dgreco-debug/cat-tracker/(commit log)

2026-10-14 Cat tracker: collar + base firmware v2 and web app
    Collar (XIAO nRF52840 + Wio-SX1262 + M10 GPS): periodic GPS reports over LoRa,
    settings saved in flash and changeable over LoRa, Bluetooth or USB.
    Base (Heltec V4): BLE/USB JSON bridge, command queue, history, chat between bases.
    App (Vite + Preact + Leaflet PWA): live map with trail and distance to the cat,
    collar settings, activity log, chat, demo mode. Deployed to GitHub Pages.
    Claude-Session: https://claude.ai/code/session_01GZnRQ6rdyr5X5z8jqkyW2t
    [partitions.csv]
2026-10-14 Add handoff doc, CLAUDE.md, and collar restart-into-update-mode
    - HANDOFF.md: state at handoff, what is verified vs untested, build/flash notes, open questions
    - CLAUDE.md: repo conventions for Claude Code
    - Collar: {"cmd":"dfu"} / 'dfu' restarts into the UF2 bootloader; app button in Collar tab
    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
2026-10-14 App: 100 mAh battery estimate and days-left countdown from recent check-ins
    - Settings estimate now assumes a 100 mAh cell instead of 400 mAh.
    - New "days left" tile: fits a line to state of charge over the last 10
    check-ins on battery (stopping at the last USB check-in) and projects to
    a 3.0 V cutoff. Shows "Charging" on USB.
    - Battery percent curve now reaches 0% at 3.0 V instead of 3.3 V.
    - HANDOFF.md: 100 mAh battery, collar v2 flashed, hardware test results,
    and the v2 firmware review findings.
2026-10-14 Firmware 2.1: reset reason, radio recovery, review fixes #1 and #2; clearer battery countdown
    Collar 2.1
    - Records why it last restarted (readResetReason) and reports it in the boot
    log, in status (reset, reset_code) and over LoRa in the boot report's
    last_cmd byte (packet stays 24 bytes).
    - After a failed transmit, re-initialises the SX1262 and retries once; counts
    it in status (radio_reinits). On 2.0 a field unit got stuck with every
    transmit timing out (-5) until restarted.
    - Bluetooth advertising now stops after a charge (review #1).
    Base 2.1
    - Restarts receive after acknowledging a chat message (review #2).
    - Adds reset to boot reports' JSON and no longer treats a boot report's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
    [main.cpp, protocol.h]
2026-10-14 Firmware 2.2: collar temperature in live reports
    - Collar reads the nRF52840 die temperature at the start of each check-in and
    sends a new report type 0x04 (ReportT): accuracy shrinks to 1 byte (255 =
    255 m or worse) to make room for temperature in 0.5 degC steps. Still 24
    bytes. Also in status and the local Bluetooth report as temp_c.
    - Base accepts both 0x01 and 0x04 reports, keeps temperature in history and
    adds temp_c to report JSON.
    - App: temperature tile on the Collar page (F with C), activity log line,
    CSV column, demo data.
    - PROTOCOL.md and HANDOFF.md updated. Base 2.2 flashed and verified with a
    2.1 collar; collar 2.2 built, not yet flashed.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
2026-10-14 Base 2.3: compass screen with distance and direction; signal %
    Base
    - New OLED screen: compass needle from the base to the collar, distance in
    ft/mi, 8-point direction and position age, battery %, signal % and
    temperature; short banners for find queued, command done, chat, home set.
    - Home (base location) stored in flash only: hold PRG 2 s to take the
    collar's last position, set_home JSON (from collar, lat/lon, or clear),
    or USB "home [lat lon]". hello includes home; new home event.
    - Short PRG press still queues find mode.
    App
    - Signal shown as 0-100% (same formula as the base screen), dBm and SNR
    kept as detail; activity log uses %.
    - "Set base location from collar" button when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
    [main.cpp]
2026-10-14 Base screen: satellites drawn as small satellite icons around the compass ring
    One 9x3 satellite icon per satellite in use (up to 12), spaced evenly
    around the ring and offset so none covers the N. Needle shortened so its
    tip stays clear of them.
    [main.cpp]
2026-10-15 Firmware 2.4: report confirmation, radio self-healing, travel distance
    Field finding: after a drive the collar logged "Sent report" every cycle
    (39 radio re-inits) while the base beside it heard nothing until the collar
    was reset, so the SX1262 can claim a successful transmit with nothing sent.
    Collar 2.4
    - Waits for the base to confirm each report (new 0x05 report ack, or a
    queued command). Green x5 on confirmation, red x3 without.
    - Fully resets the radio after 3 unconfirmed reports in a row.
    - status: missed_acks, noack_resets, last_ack_s.
    - Default transmit power 17 dBm (stored settings keep their value).
    Base 2.4
    - Sends a report ack when nothing is queued.
    - Re-initialises its radi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
    [main.cpp, protocol.h]
